himansh107/nitjsr_pll_130nm/block diagram.png

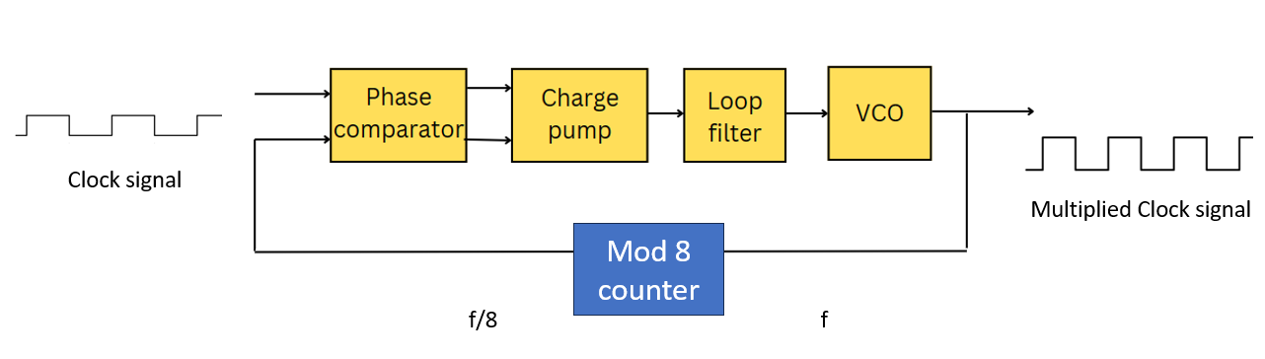
block diagram.png
