himansh107/nitjsr_pll_130nm/post layout/layouts/charge pump.png

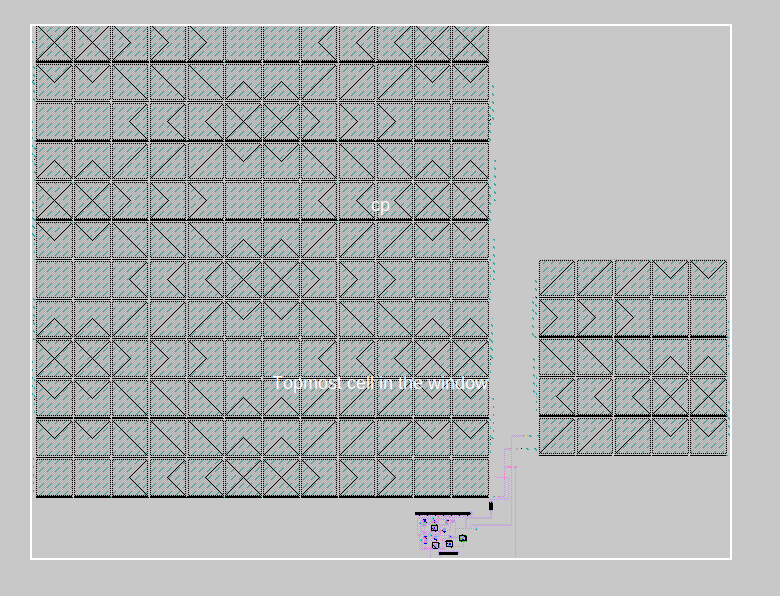
post layout/layouts/charge pump.png
