himansh107/nitjsr_pll_130nm/post layout/layouts/cp_closeup.png

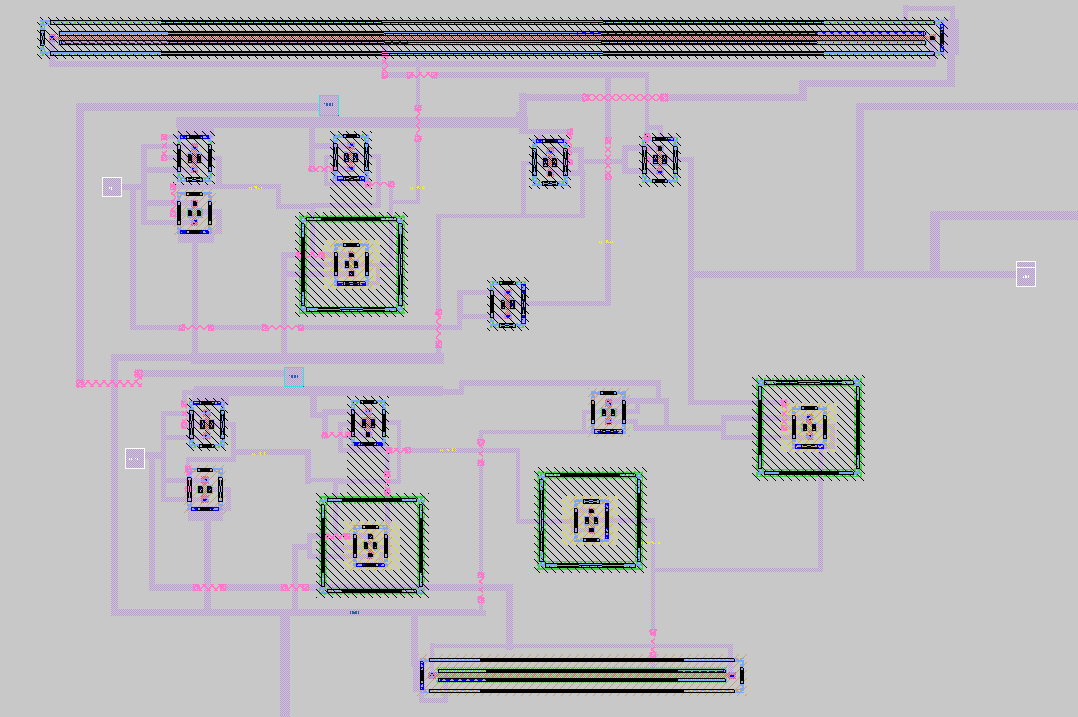
post layout/layouts/cp_closeup.png
