himansh107/nitjsr_pll_130nm/post layout/layouts/fd.png

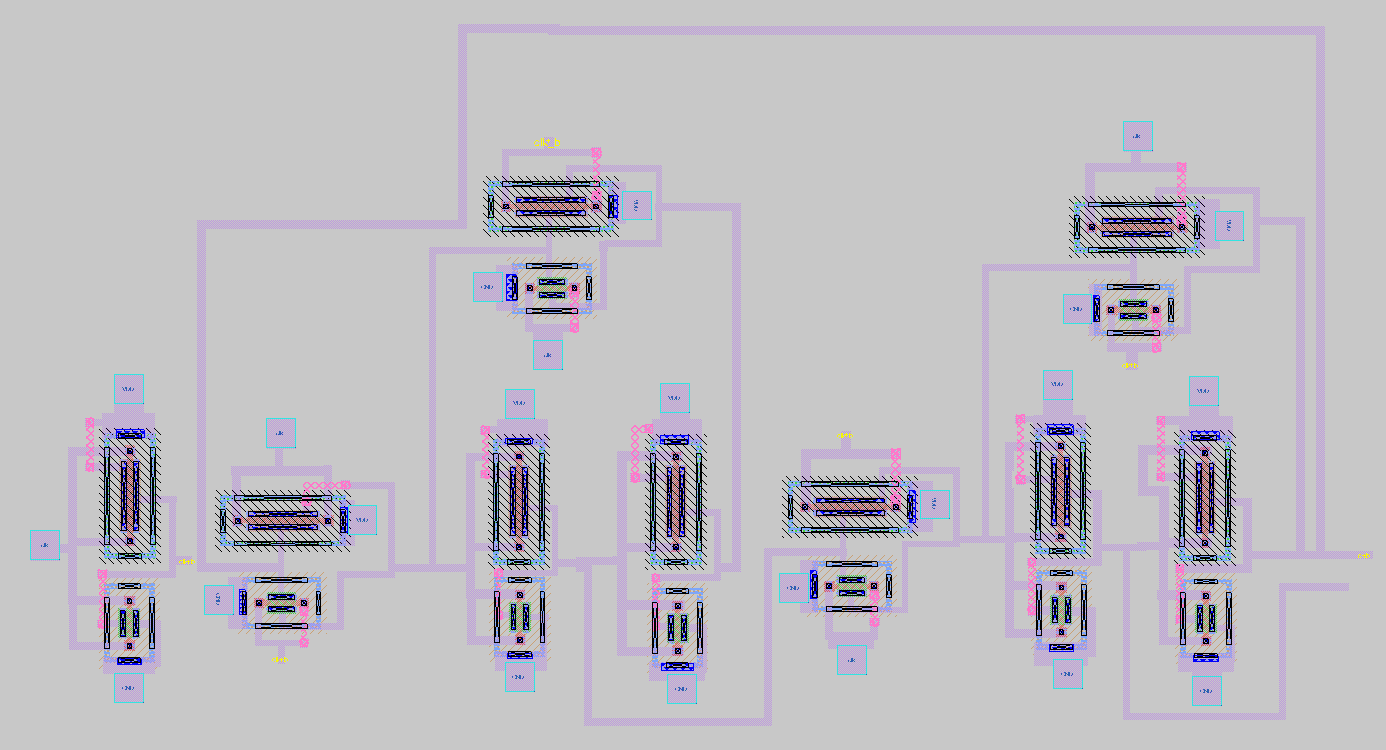
post layout/layouts/fd.png
