himansh107/nitjsr_pll_130nm/post layout/layouts/fd_8.png

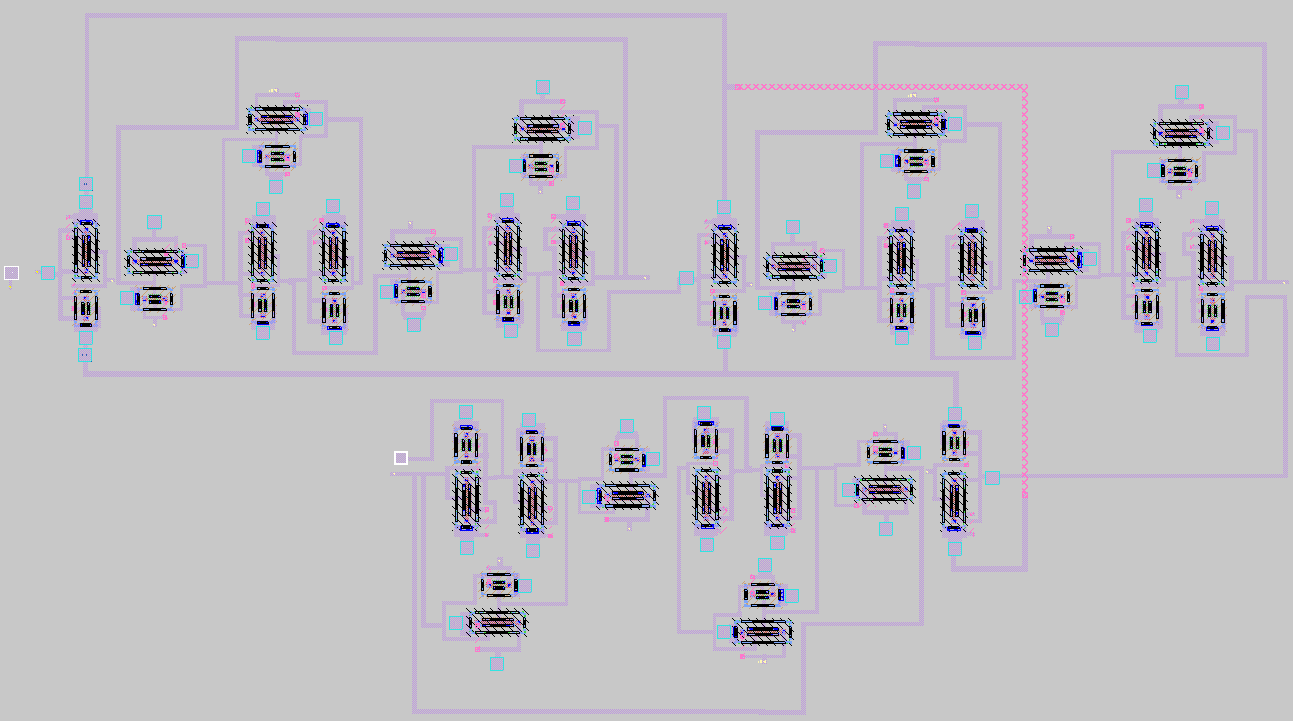
post layout/layouts/fd_8.png
