himansh107/nitjsr_pll_130nm/post layout/layouts/pfd.png

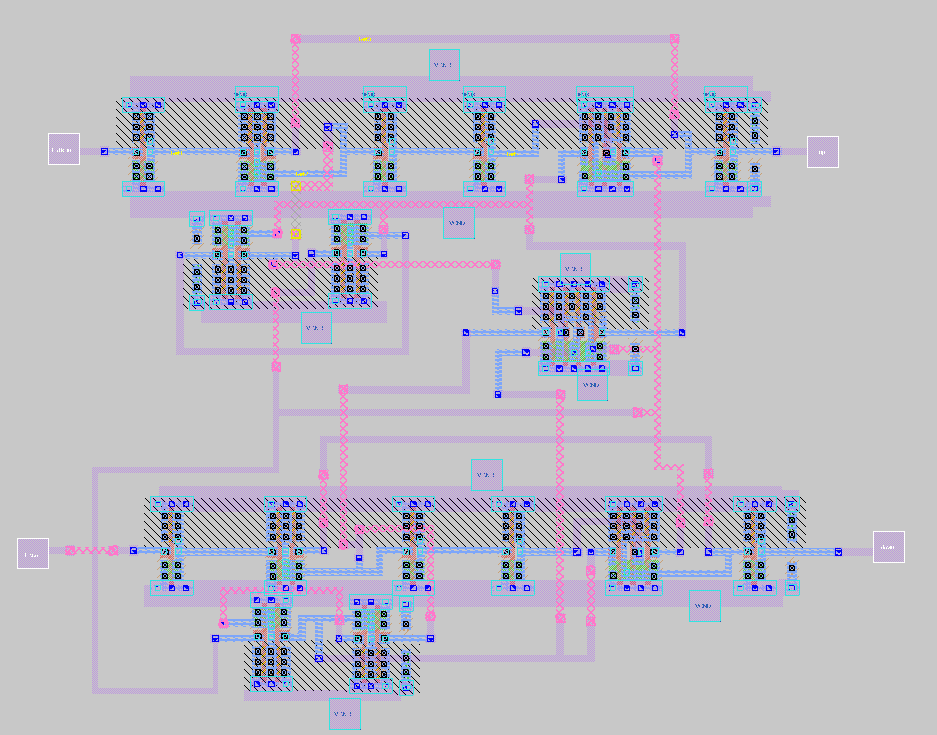
post layout/layouts/pfd.png
