himansh107/nitjsr_pll_130nm/post layout/layouts/pll close up.png

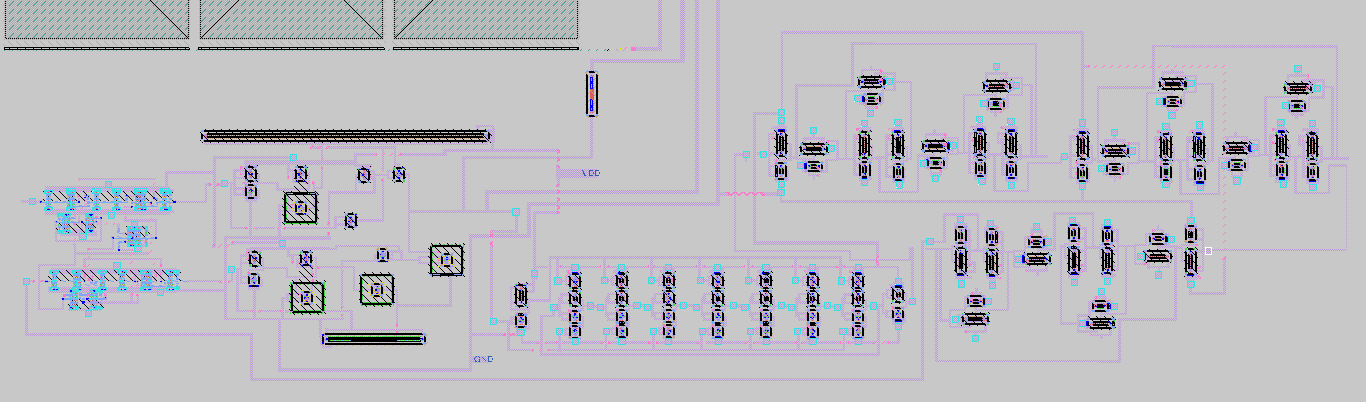
post layout/layouts/pll close up.png
