himansh107/nitjsr_pll_130nm/post layout/layouts/pll.png

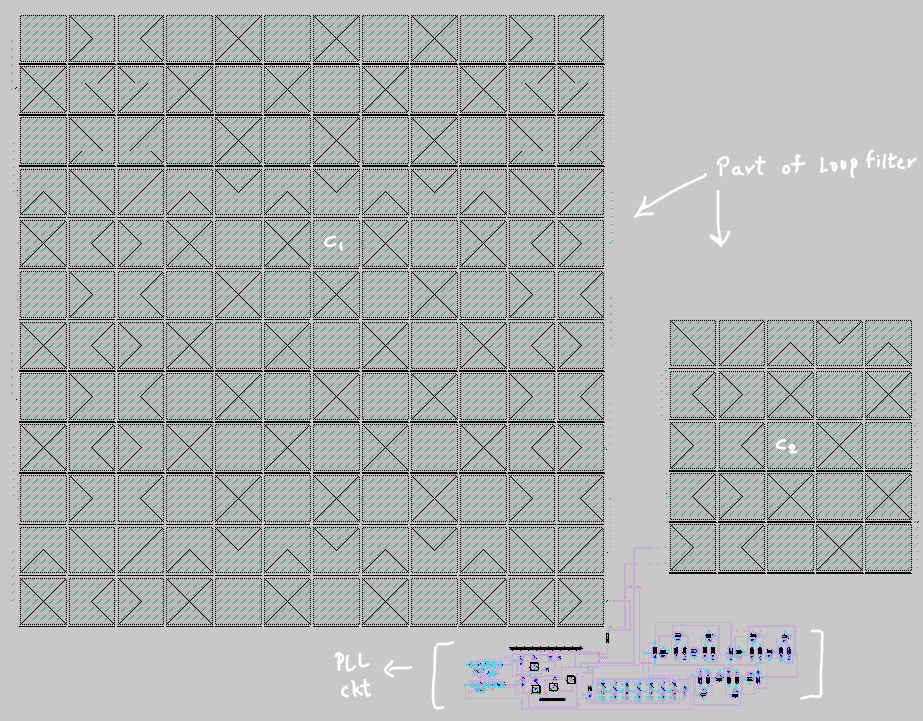
post layout/layouts/pll.png
