himansh107/nitjsr_pll_130nm/post layout/layouts/vco.png

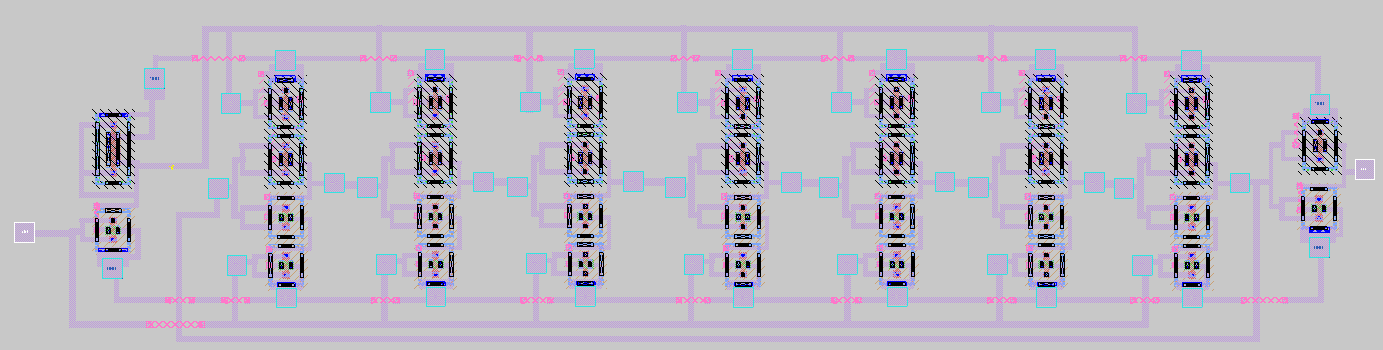
post layout/layouts/vco.png
