himansh107/nitjsr_pll_130nm/pre layout/schematics/cp.png

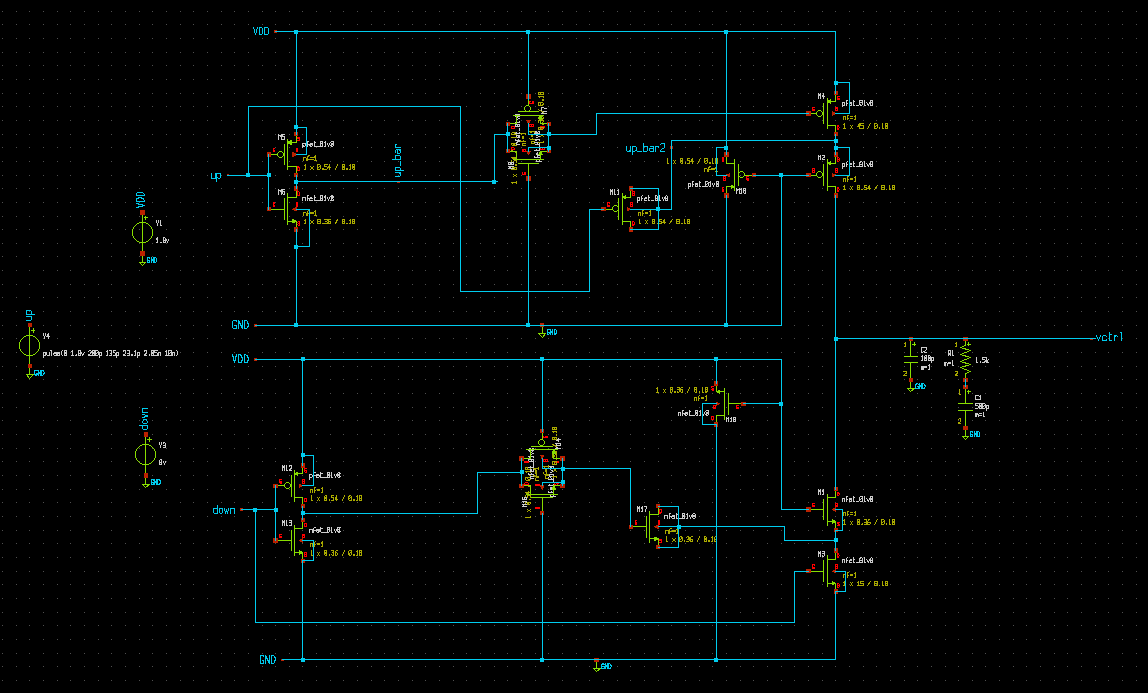
pre layout/schematics/cp.png
