himansh107/nitjsr_pll_130nm/pre layout/schematics/fd.png

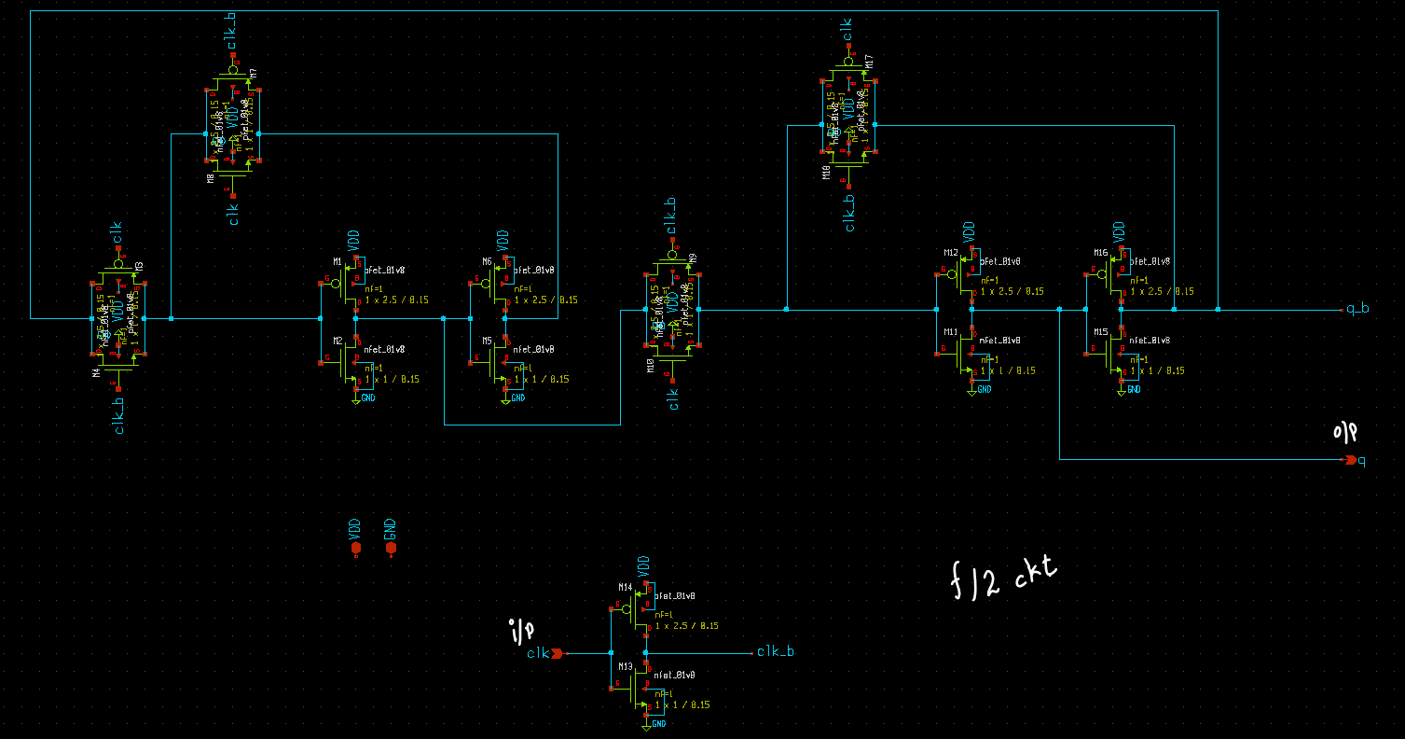
pre layout/schematics/fd.png
