himansh107/nitjsr_pll_130nm/pre layout/schematics/lf.png

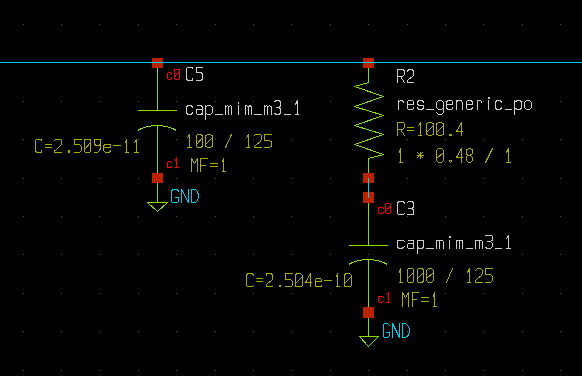
pre layout/schematics/lf.png
