himansh107/nitjsr_pll_130nm/pre layout/schematics/pfd.png

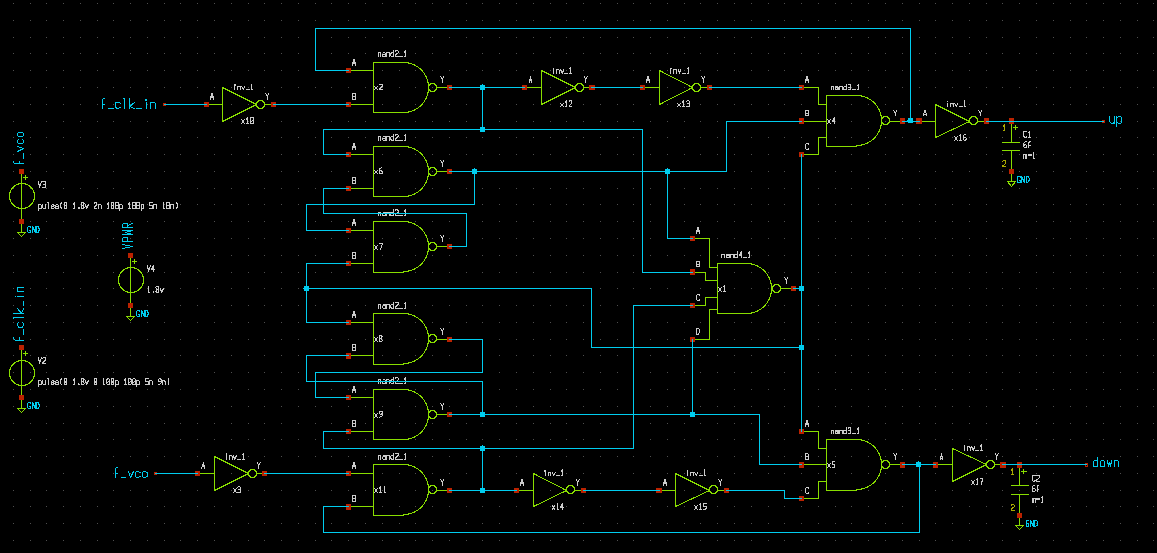
pre layout/schematics/pfd.png
