himansh107/nitjsr_pll_130nm/pre layout/schematics/pll.png

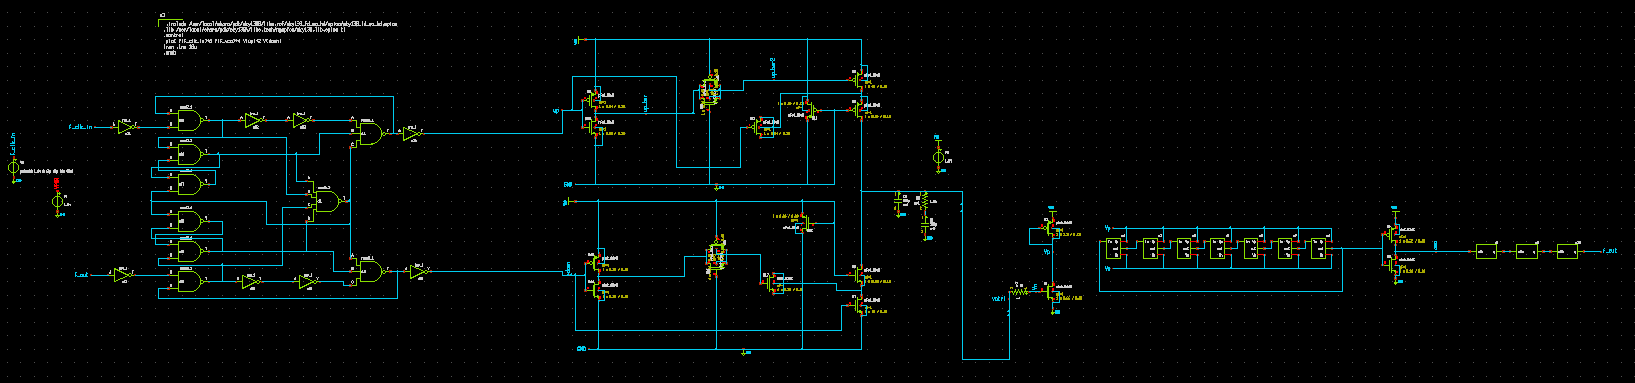
pre layout/schematics/pll.png
