himansh107/nitjsr_pll_130nm/pre layout/schematics/vco.png

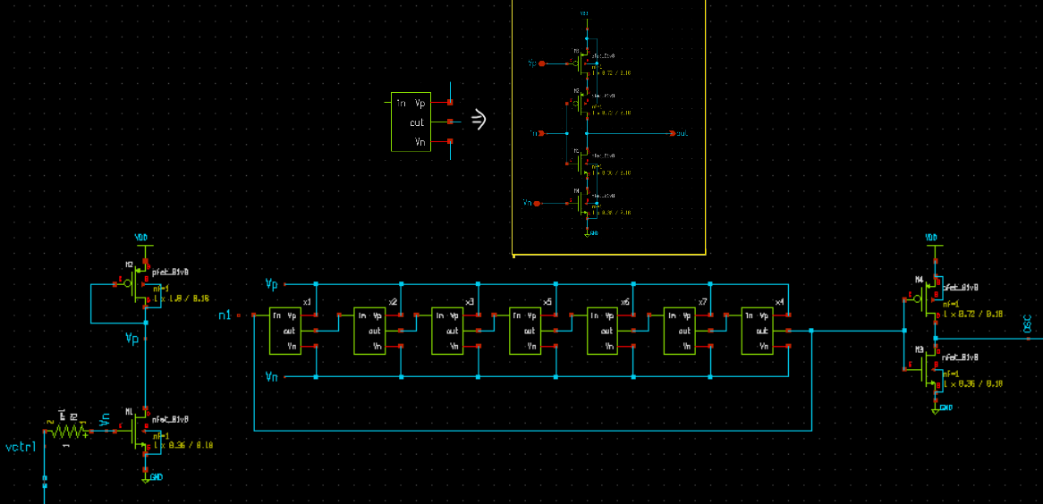
pre layout/schematics/vco.png
