himansh107/nitjsr_pll_130nm/pre layout/simulation_results/5mhz, 40.98mhz, 12us.png

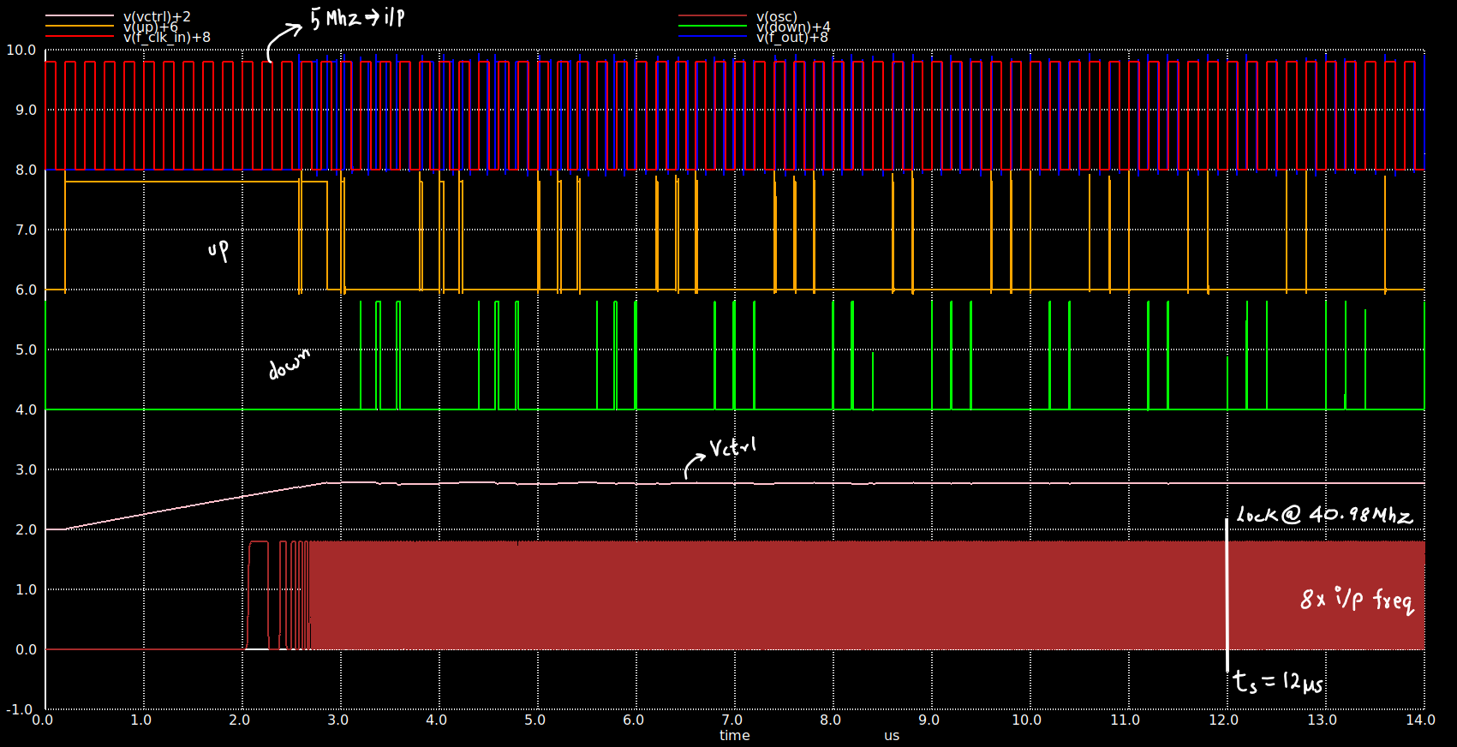
pre layout/simulation_results/5mhz, 40.98mhz, 12us.png
