himansh107/nitjsr_pll_130nm/pre layout/simulation_results/12.5mhz, 100mhz, 9us.png

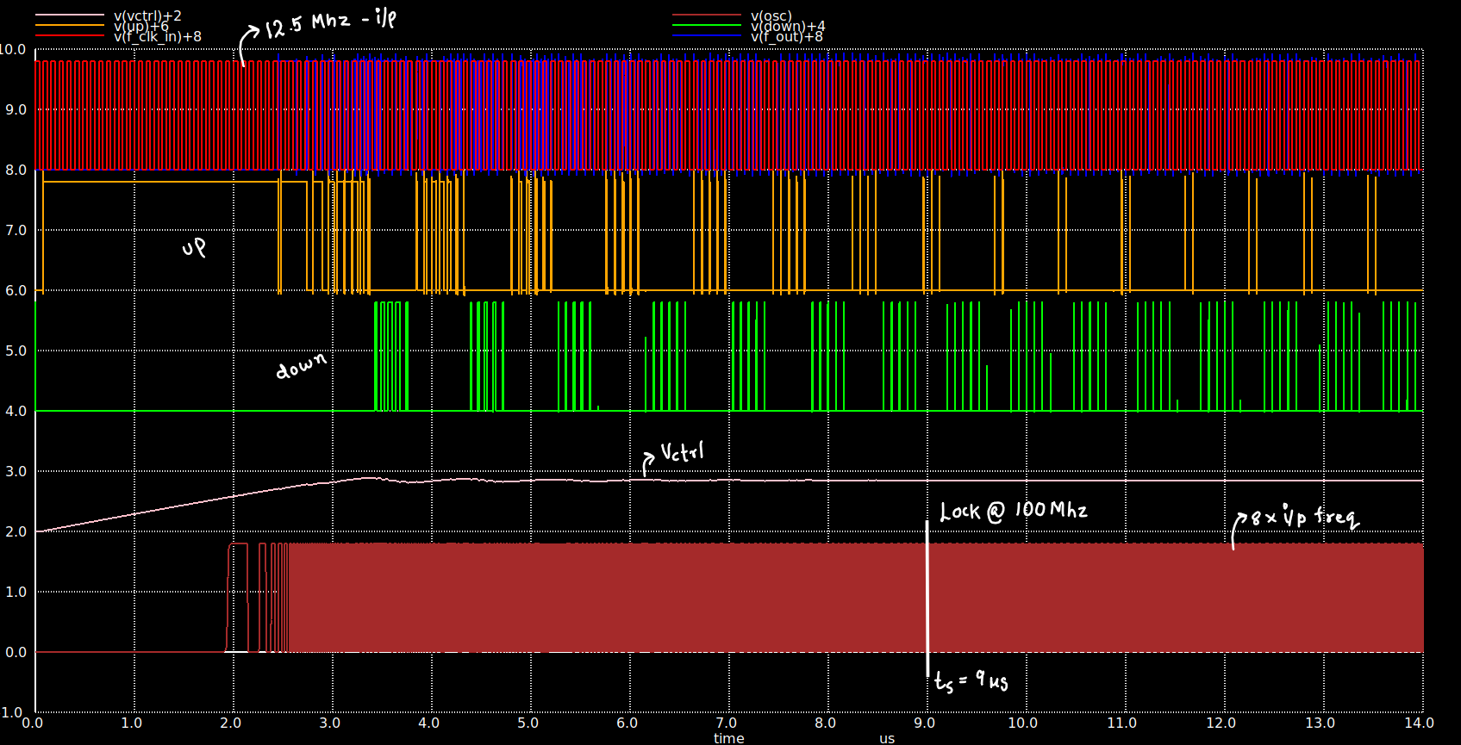
pre layout/simulation_results/12.5mhz, 100mhz, 9us.png
