himansh107/nitjsr_pll_130nm/pre layout/simulation_results/close up for 100mhz op.png

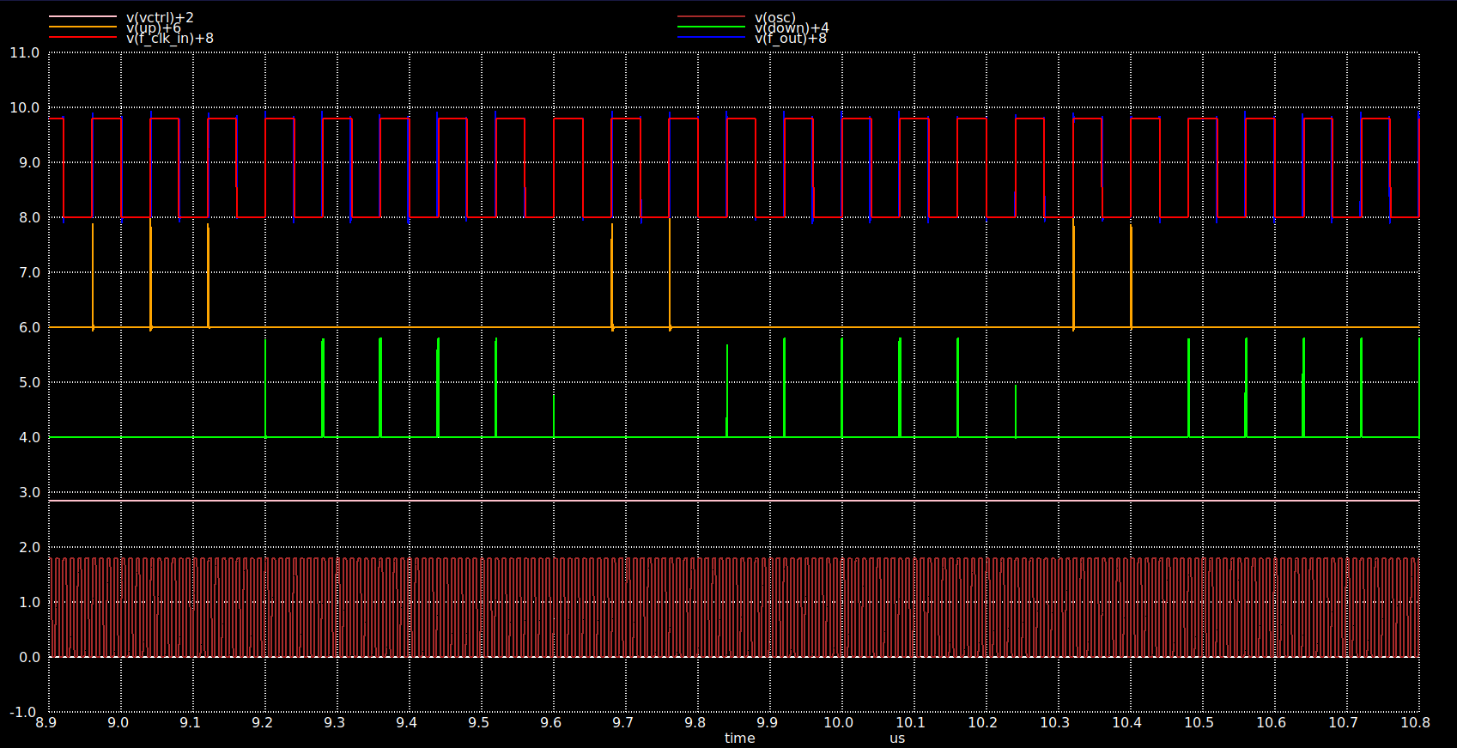
pre layout/simulation_results/close up for 100mhz op.png
