himansh107/nitjsr_pll_130nm/pre layout/simulation_results/cp_down.png

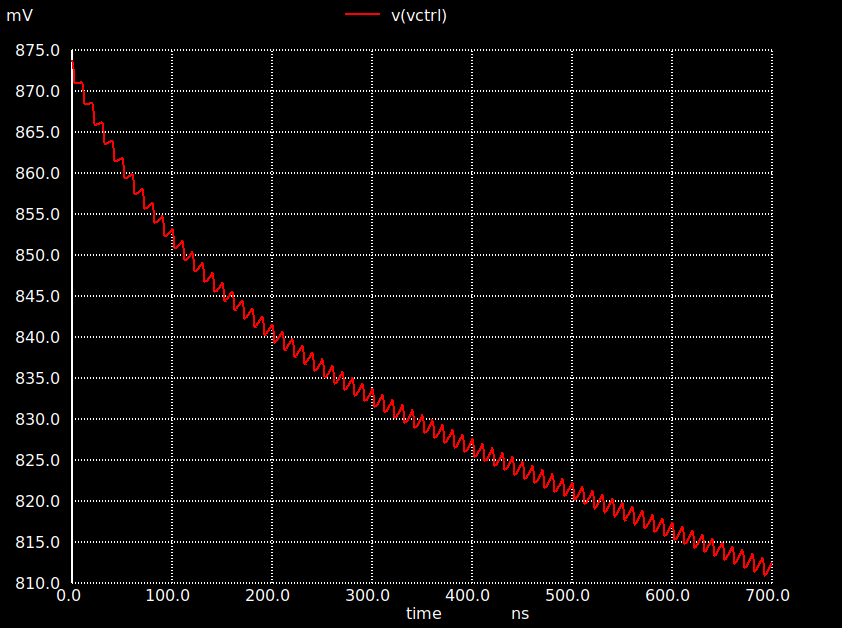
pre layout/simulation_results/cp_down.png
