himansh107/nitjsr_pll_130nm/pre layout/simulation_results/cp_up.png

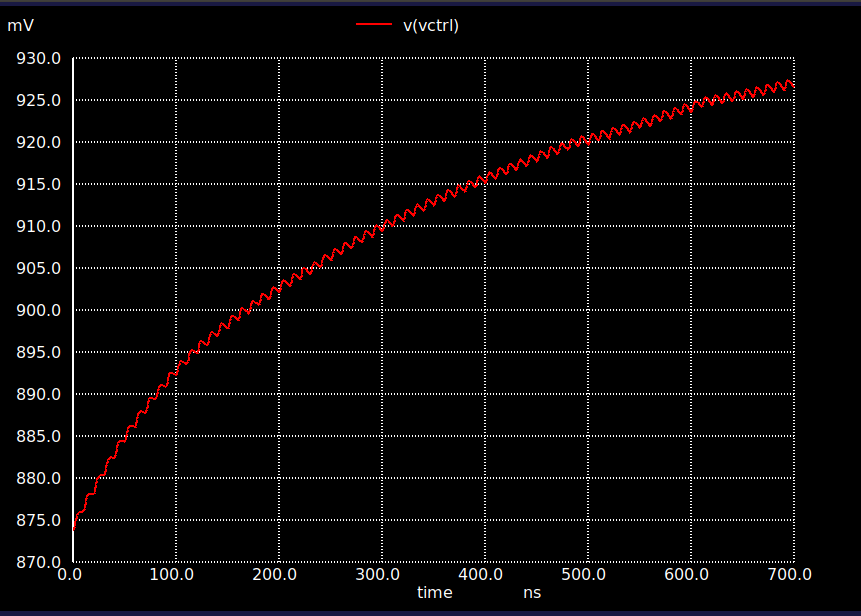
pre layout/simulation_results/cp_up.png
