himansh107/nitjsr_pll_130nm/pre layout/simulation_results/fd.png

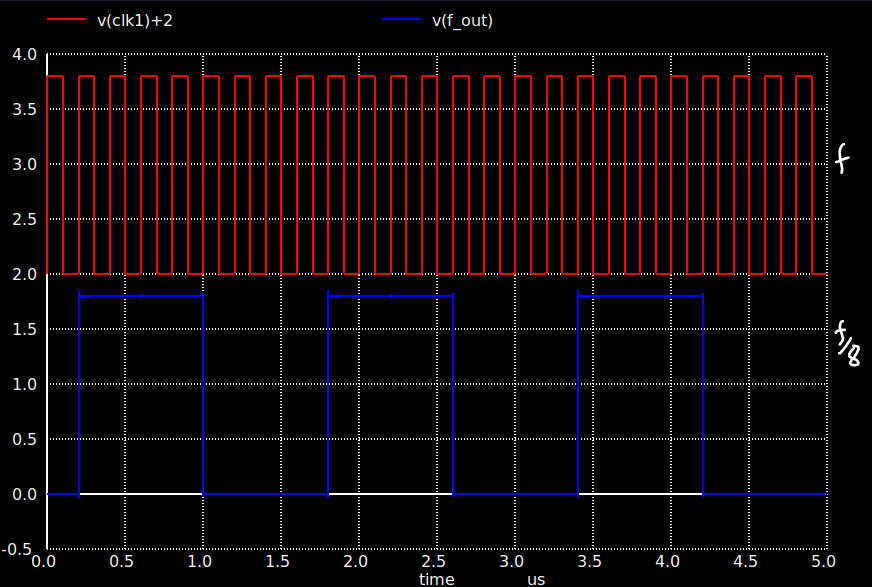
pre layout/simulation_results/fd.png
