himansh107/nitjsr_pll_130nm/pre layout/simulation_results/pfd_sim.png

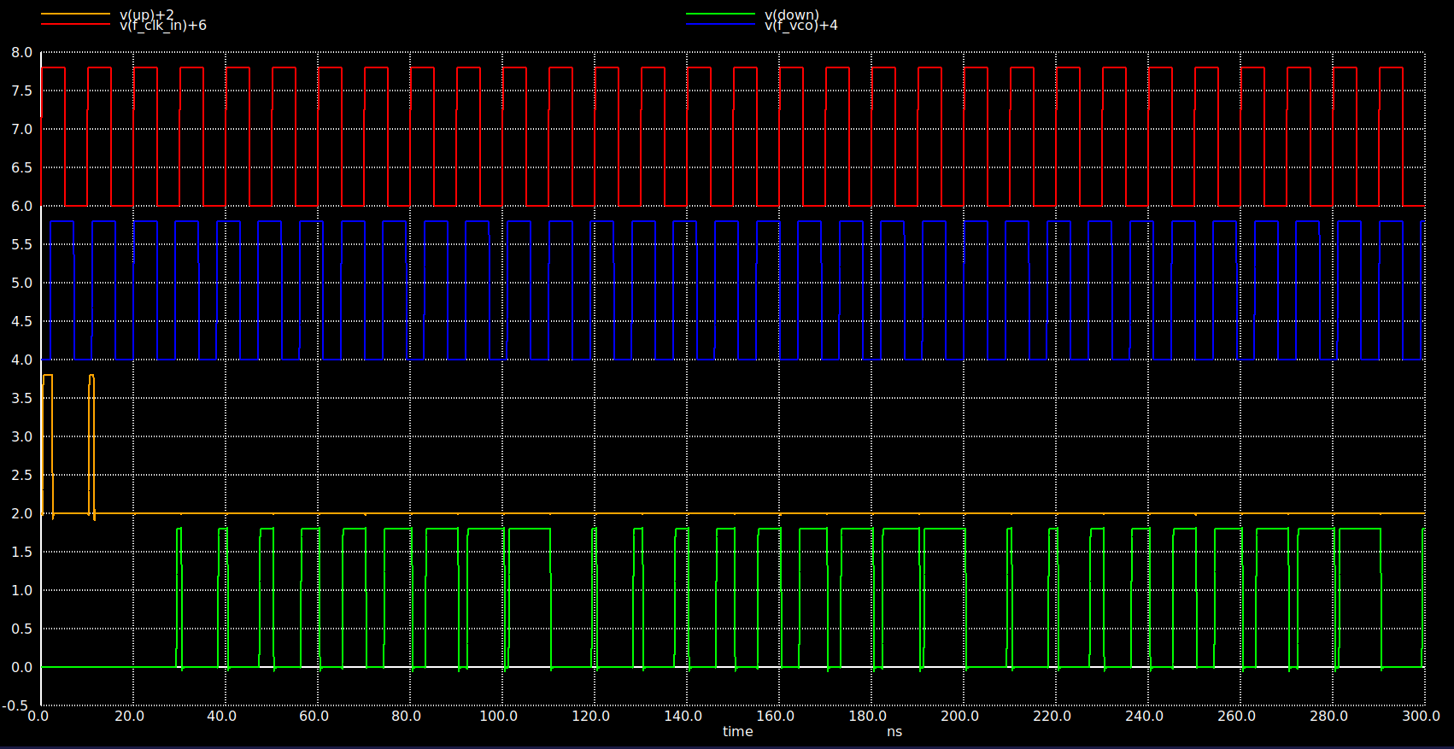
pre layout/simulation_results/pfd_sim.png
