himansh107/nitjsr_pll_130nm/pre layout/simulation_results/pfd_sim_const_phase_difference.png

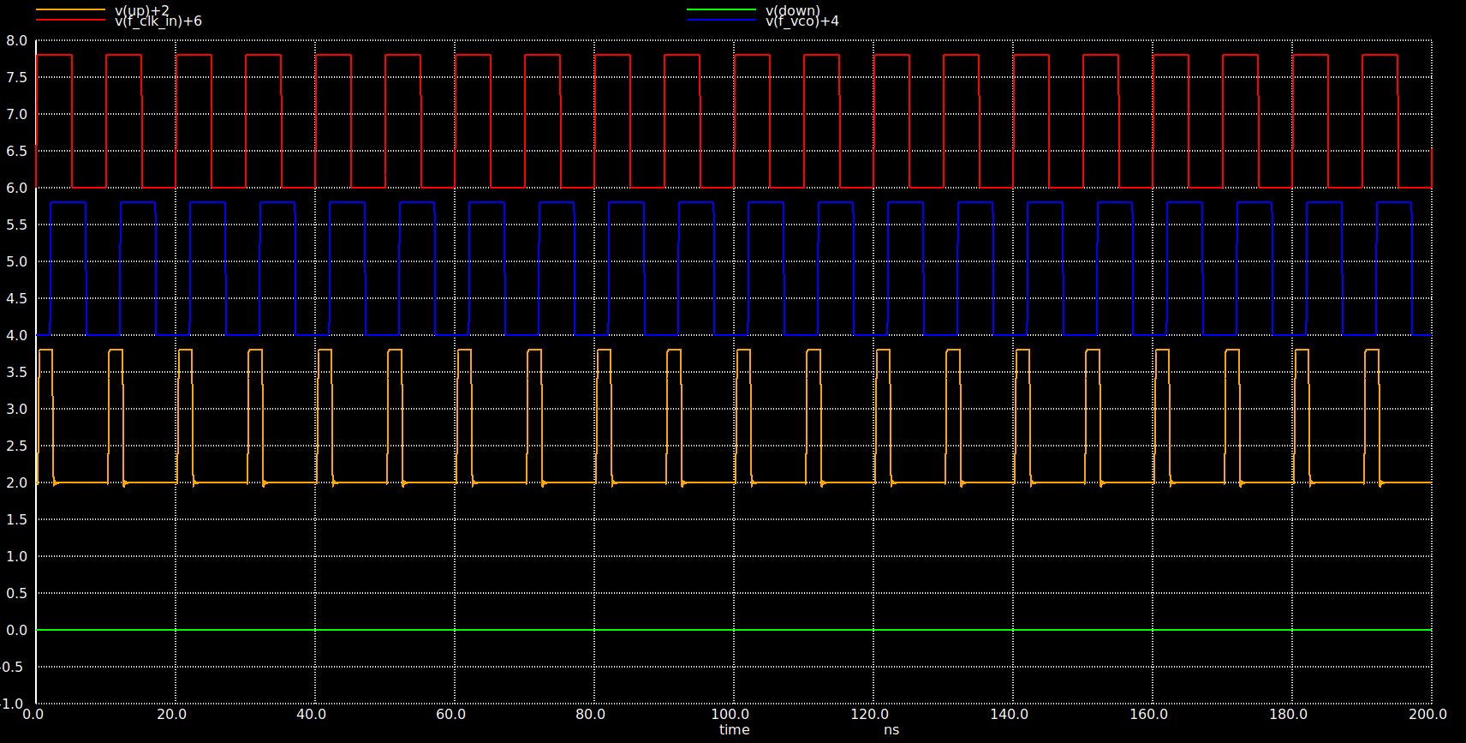
pre layout/simulation_results/pfd_sim_const_phase_difference.png
