himansh107/nitjsr_pll_130nm/pre layout/simulation_results/vco_op.png

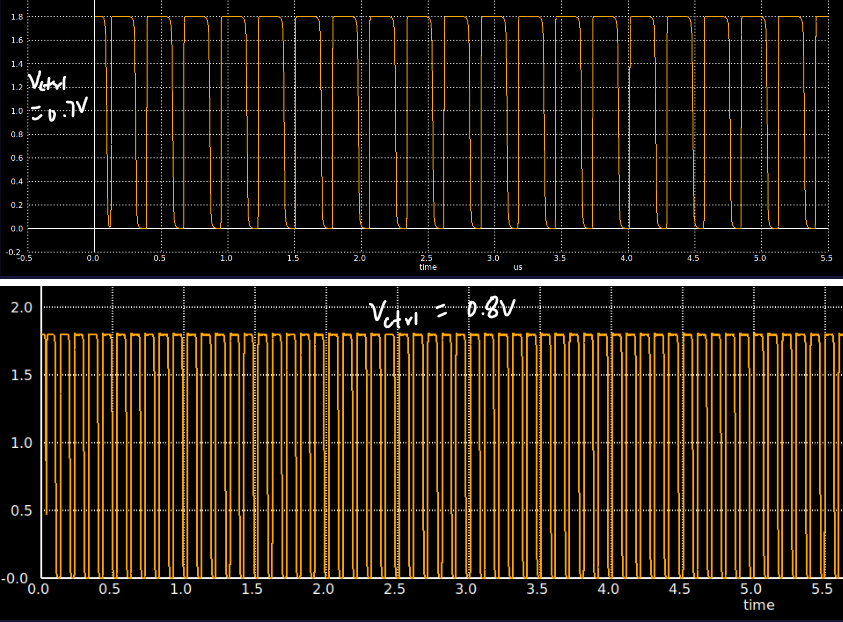
pre layout/simulation_results/vco_op.png
